Rxdfish/peekboard/images/backligh_schematic.png

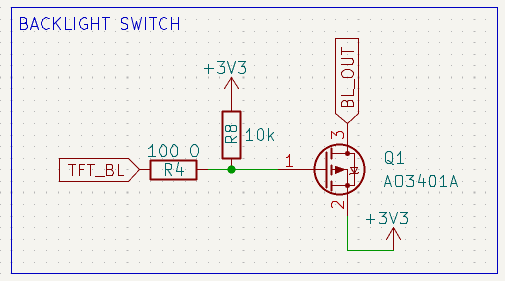
images/backligh_schematic.png
