Rxdfish/peekboard/images/controls_schematic.png

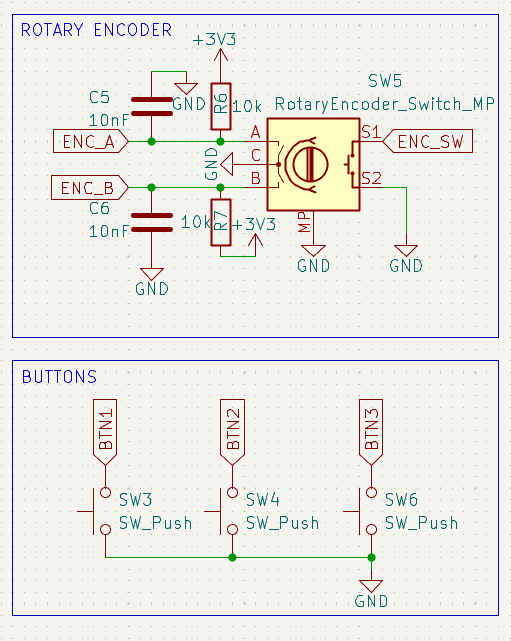
images/controls_schematic.png
