Rxdfish/peekboard/images/ESD_schematic.png

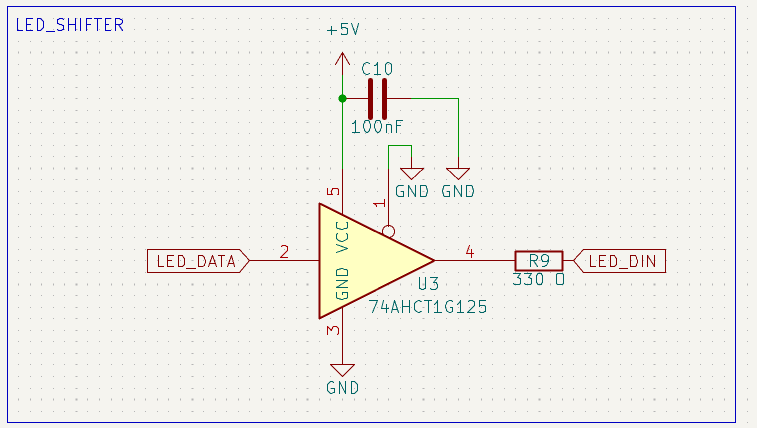
images/ESD_schematic.png
