Rxdfish/peekboard/images/Esp_schematic.png

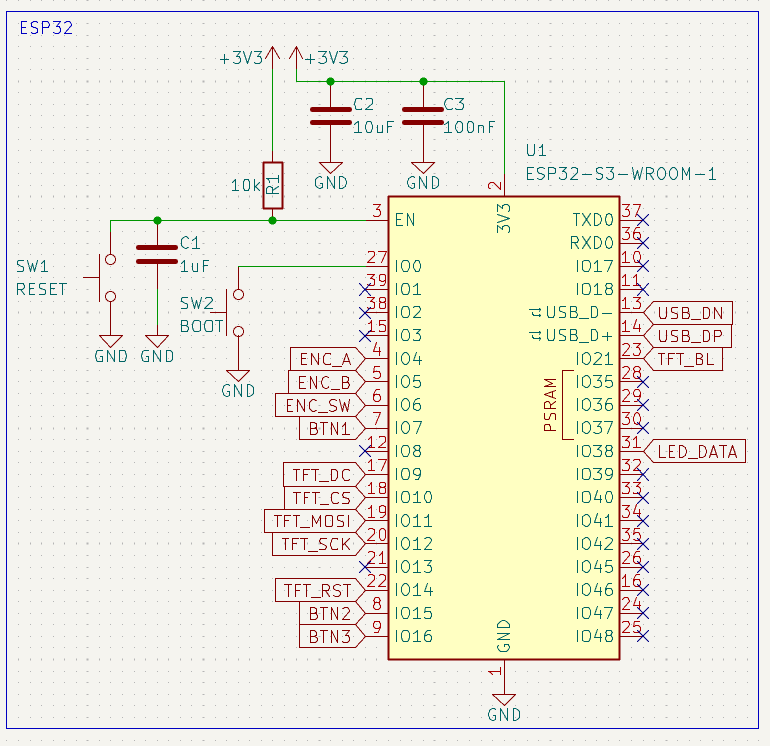
images/Esp_schematic.png
