Rxdfish/peekboard/images/LDO_schematic.png

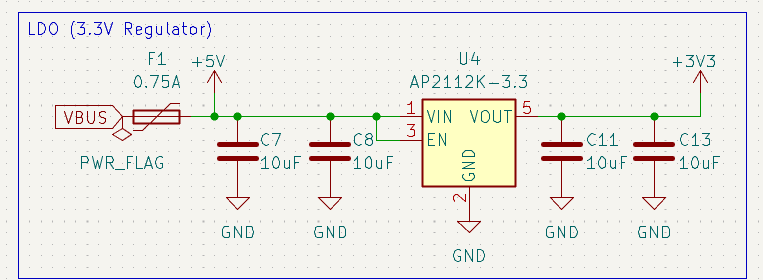
images/LDO_schematic.png
