Rxdfish/peekboard/images/LED_schematic.png

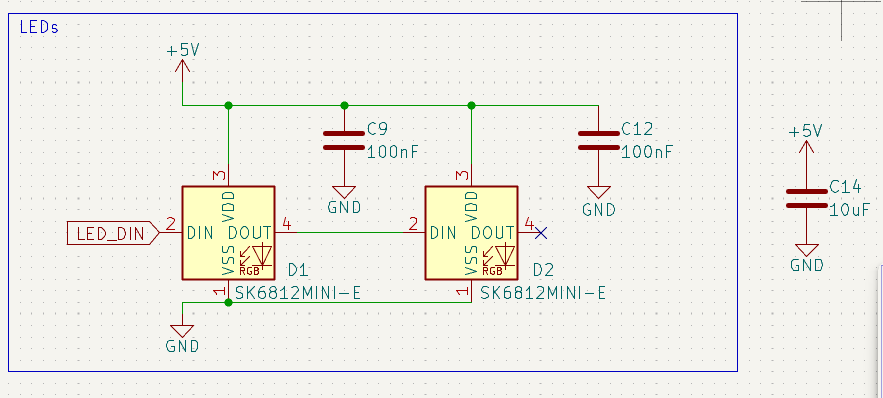
images/LED_schematic.png
