Rxdfish/peekboard/images/screen_schematic.png

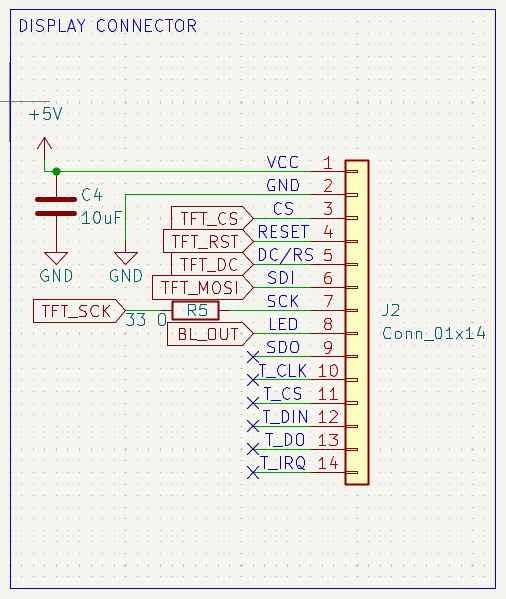
images/screen_schematic.png
