Rxdfish/peekboard/images/USB_schematic.png

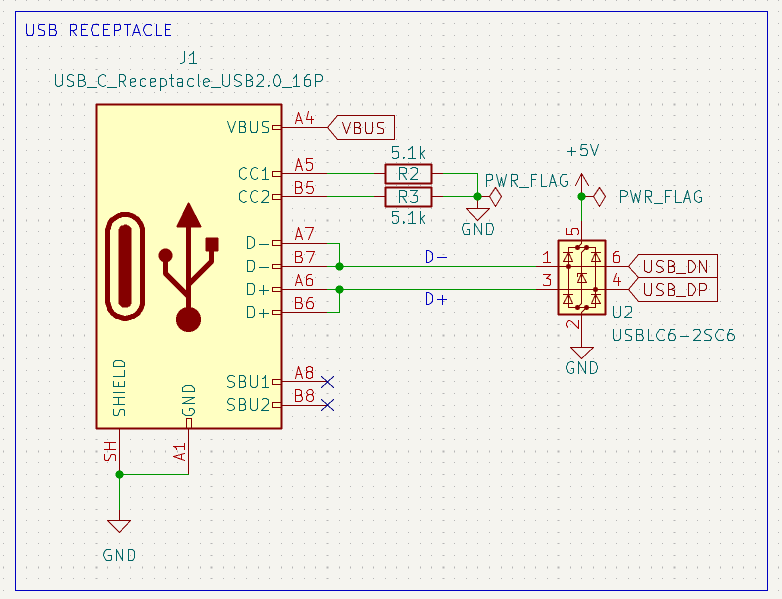
images/USB_schematic.png
