Rxdfish/peekboard/BOM2/Peekboard_Project.csv

Id | Designator | Footprint | Quantity | Designation | Supplier and ref
1 | C1 | C_0805_2012Metric_Pad1.18x1.45mm_HandSolder | 1 | 1uF
2 | C2, C4, C7, C8, C11, C13, C14 | C_0805_2012Metric_Pad1.18x1.45mm_HandSolder | 7 | 10uF
3 | C3, C9, C10, C12 | C_0805_2012Metric_Pad1.18x1.45mm_HandSolder | 4 | 100nF
4 | C5, C6 | C_0805_2012Metric_Pad1.18x1.45mm_HandSolder | 2 | 10nF
5 | D1, D2 | LED_SK6812MINI-E_3.2x2.8mm_P1.5mm_ReverseMount | 2 | SK6812MINI-E
6 | F1 | Fuse_1206_3216Metric_Pad1.42x1.75mm_HandSolder | 1 | 0.75A
7 | J1 | USB_C_Receptacle_HRO_TYPE-C-31-M-12 | 1 | USB_C_Receptacle_USB2.0_16P
8 | J2 | MSP4030_Module | 1 | Conn_01x14
9 | Q1 | SOT-23 | 1 | AO3401A
10 | R1, R6, R7, R8 | R_0805_2012Metric_Pad1.20x1.40mm_HandSolder | 4 | 10k
11 | R2, R3 | R_0805_2012Metric_Pad1.20x1.40mm_HandSolder | 2 | 5.1k
12 | R4 | R_0805_2012Metric_Pad1.20x1.40mm_HandSolder | 1 | 100 O
13 | R5 | R_0805_2012Metric_Pad1.20x1.40mm_HandSolder | 1 | 33 O
14 | R9 | R_0805_2012Metric_Pad1.20x1.40mm_HandSolder | 1 | 330 O
15 | SW1 | SW_PUSH_6mm | 1 | RESET
16 | SW2 | SW_PUSH_6mm | 1 | BOOT
17 | SW3, SW4, SW6 | SW_PUSH_6mm | 3 | SW_Push
18 | SW5 | RotaryEncoder_Alps_EC11E-Switch_Vertical_H20mm | 1 | RotaryEncoder_Switch_MP
19 | U1 | ESP32-S3-WROOM-1 | 1 | ESP32-S3-WROOM-1
20 | U2 | SOT-23-6_Handsoldering | 1 | USBLC6-2SC6
21 | U3 | SOT-23-5_HandSoldering | 1 | 74AHCT1G125
22 | U4 | SOT-23-5_HandSoldering | 1 | AP2112K-3.3
