Rxdfish/peekboard/BOM.csv

Item | Qty | Supplier | Cost/item | Total Cost | link
4" st7796 SPI TFT 480x320 | 1 | EQV Official Store | $20.93 | $20.93 | https://de.aliexpress.com/item/1005007609041421.html?mp=1
USBLC6-2SC6 | 1 | Shop Hui Li Long Store | $1.72 | $1.72 | https://de.aliexpress.com/item/1005007348100430.html?mp=1
AP1221K-3.3 TRG1 | 1 | IC chip Store | $2.36 | $2.36 | https://de.aliexpress.com/item/1005005807114594.html?mp=1
AO3401A | 1 | Supermarket of electronic | $2.09 | $2.09 | https://de.aliexpress.com/item/1005006220143887.html?mp=1
Alps EC11E155244G1 | 1 | DQLZV Official Store | $1.27 | $1.27 | https://de.aliexpress.com/item/1005007644083514.html?mp=1
1206 PTC self recovery fuse 0.75A | 1 | IBUW Electronic Store | $1.93 | $1.93 | https://de.aliexpress.com/item/1005005750933997.html
Estimated total shipping | 1 |  |  | $0.00
