Rxdfish/peekboard/PCB/Peekboard_Project.step

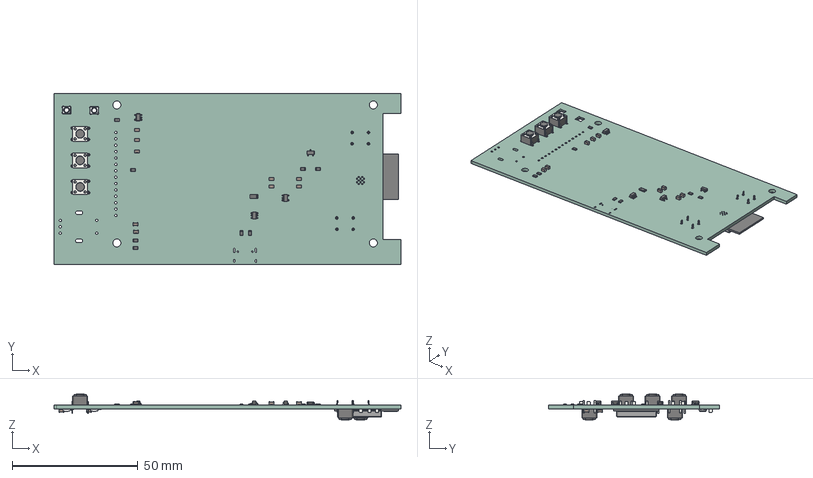
[picture p14: CAD file, 2026-11-03]
PCB/Peekboard_Project.step
138.0 x 68.0 x 10.3 mm
C_0805_2012Metric x 14
SOT-23-5 x 2
Fuse_1206_3216Metric
SOT-23-6
R_0805_2012Metric x 9
SW_PUSH_6mm x 5
SOT-23
Pin1 x 2
Pin2 x 2
Pin3 x 2
Pin4 x 2
ESP32-S3-WROOM-1
Pee4024_PCB
