Rxdfish/peekboard/(list of files, cad)

Other CAD files:
PCB/Peekboard_Project.stl
