Rxdfish/peekboard/PCB/Peekboard_Project.kicad_pcb

## KiCad design PCB/Peekboard_Project.kicad_pcb (2026-11-03)

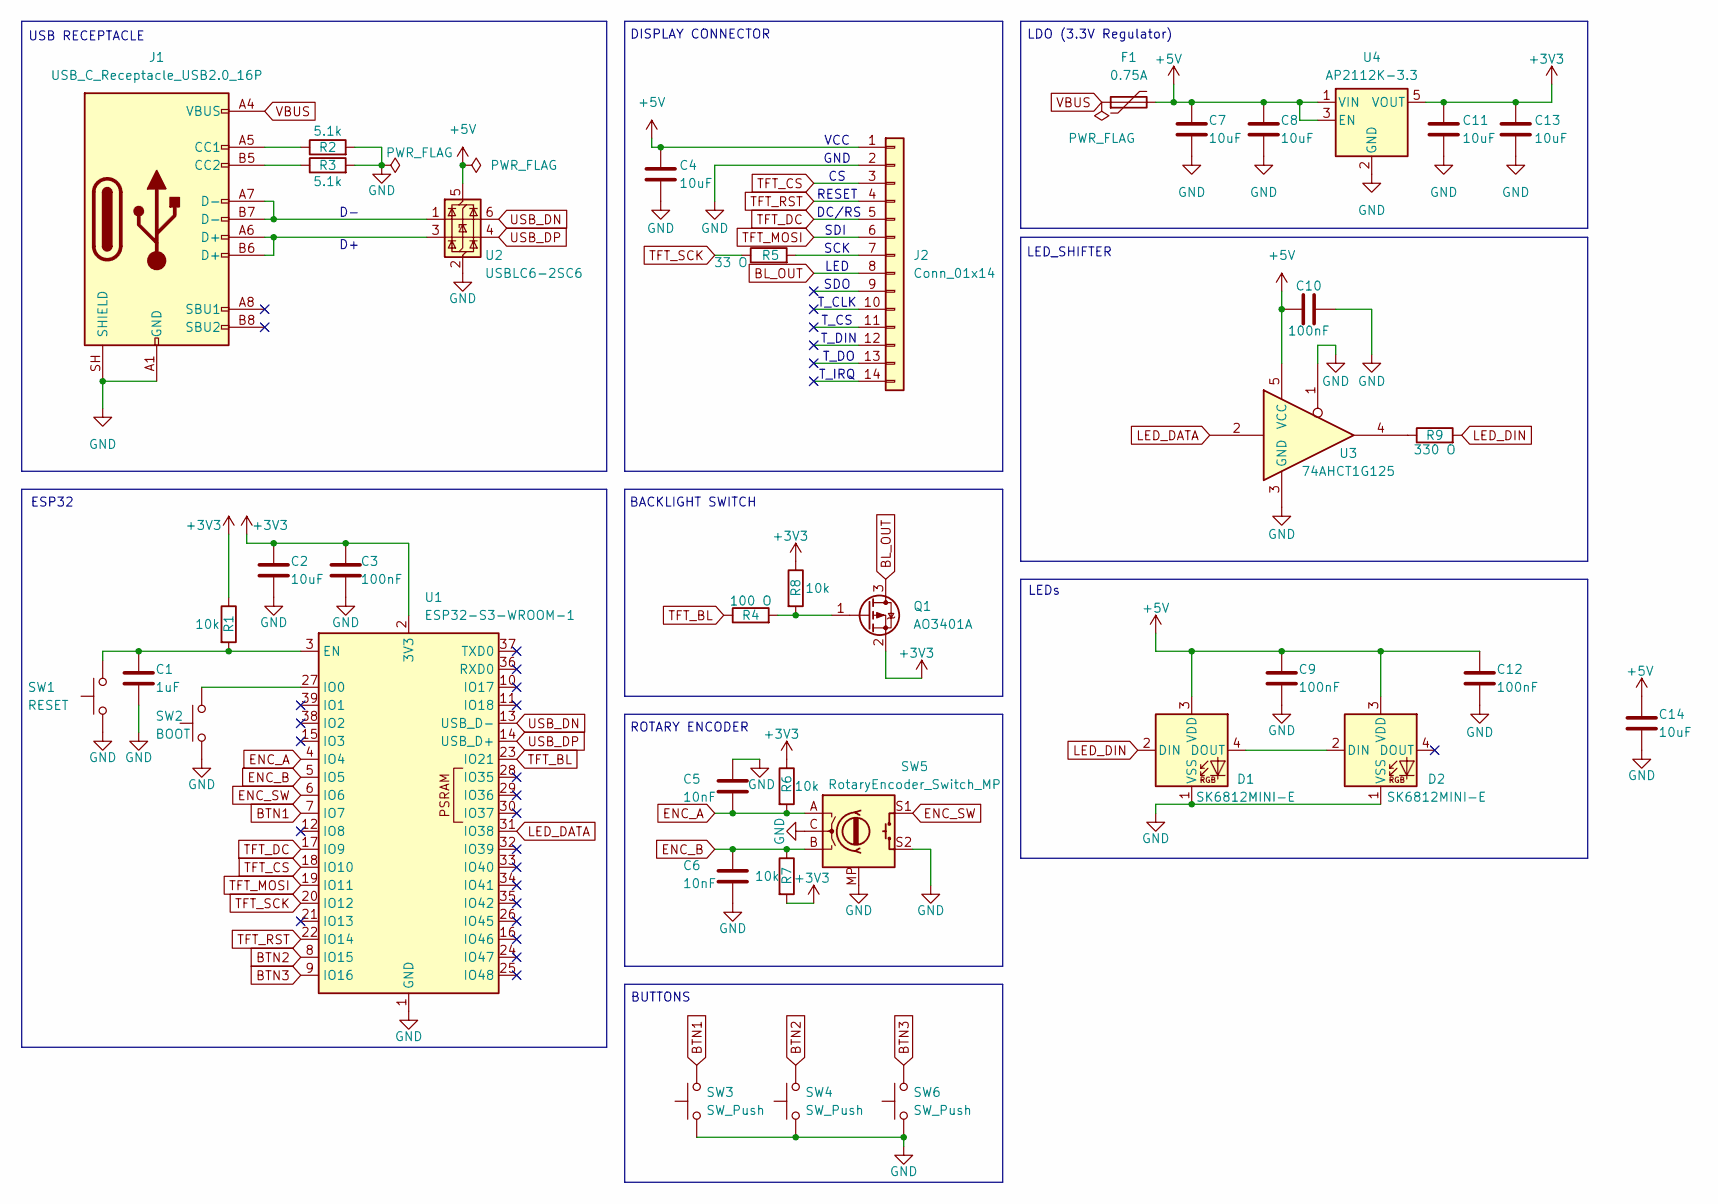
[picture p15: schematic Peekboard_Project.kicad_sch, Peekboard]

Parts:
C1: 1uF; C_0805_2012Metric_Pad1.18x1.45mm_HandSolder
C2, C4, C7, C8, C11, C13, C14: 10uF; C_0805_2012Metric_Pad1.18x1.45mm_HandSolder
C3, C9, C10, C12: 100nF; C_0805_2012Metric_Pad1.18x1.45mm_HandSolder
C5, C6: 10nF; C_0805_2012Metric_Pad1.18x1.45mm_HandSolder
D1, D2: SK6812MINI-E; LED_SK6812MINI-E_3.2x2.8mm_P1.5mm_ReverseMount
F1: 0.75A; Fuse_1206_3216Metric_Pad1.42x1.75mm_HandSolder
J1: USB_C_Receptacle_USB2.0_16P; USB_C_Receptacle_HRO_TYPE-C-31-M-12
J2: Conn_01x14; MSP4030_Module
Q1: AO3401A; SOT-23
R1, R6, R7, R8: 10k; R_0805_2012Metric_Pad1.20x1.40mm_HandSolder
R2, R3: 5.1k; R_0805_2012Metric_Pad1.20x1.40mm_HandSolder
R4: 100 O; R_0805_2012Metric_Pad1.20x1.40mm_HandSolder
R5: 33 O; R_0805_2012Metric_Pad1.20x1.40mm_HandSolder
R9: 330 O; R_0805_2012Metric_Pad1.20x1.40mm_HandSolder
SW1: RESET; SW_PUSH_6mm
SW2: BOOT; SW_PUSH_6mm
SW3, SW4, SW6: SW_Push; SW_PUSH_6mm
SW5: RotaryEncoder_Switch_MP; RotaryEncoder_Alps_EC11E-Switch_Vertical_H20mm
U1: ESP32-S3-WROOM-1
U2: USBLC6-2SC6; SOT-23-6_Handsoldering
U3: 74AHCT1G125; SOT-23-5_HandSoldering
U4: AP2112K-3.3; SOT-23-5_HandSoldering

Connections:
+3V3: C2.1, C3.1, C11.1, C13.1, Q1.2 (S), R1.1, R6.1, R7.2, R8.1, U1.2 (3V3), U4.5 (VOUT)
+5V: C4.1, C7.1, C8.1, C9.1, C10.1, C12.1, C14.1, D1.3 (VDD), D2.3 (VDD), F1.2, J2.1, U2.5 (VBUS), U3.5 (VCC), U4.1 (VIN), U4.3 (EN)
BL_OUT: J2.8, Q1.3 (D)
BTN1: SW3.2, U1.7 (IO7)
BTN2: SW4.2, U1.8 (IO15)
BTN3: SW6.2, U1.9 (IO16)
ENC_A: C5.2, R6.2, SW5.A, U1.4 (IO4)
ENC_B: C6.1, R7.1, SW5.B, U1.5 (IO5)
ENC_SW: SW5.S1, U1.6 (IO6)
GND: C1.2, C2.2, C3.2, C4.2, C5.1, C6.2, C7.2, C8.2, C9.2, C10.2, C11.2, C12.2, C13.2, C14.2, D1.1 (VSS), D2.1 (VSS), J1.A1 (GND), J1.A12 (GND), J1.B1 (GND), J1.B12 (GND), J1.SH (SHIELD), J2.2, R2.2, R3.2, SW1.1, SW2.1, SW3.1, SW4.1, SW5.C, SW5.MP, SW5.S2, SW6.1, U1.1 (GND), U1.40 (GND), U1.41 (GND), U2.2 (GND), U3.1, U3.3 (GND), U4.2 (GND)
LED_DATA: U1.31 (IO38), U3.2
LED_DIN: D1.2 (DIN), R9.2
unnamed: D1.4 (DOUT), D2.2 (DIN)
unnamed: J1.A5 (CC1), R2.1
unnamed: J1.B5 (CC2), R3.1
unnamed: J1.A6 (D+), J1.B6 (D+), U2.3 (I/O2)
unnamed: J1.A7 (D-), J1.B7 (D-), U2.1 (I/O1)
unnamed: J2.7, R5.2
unnamed: Q1.1 (G), R4.2, R8.2
unnamed: R9.1, U3.4
unnamed: C1.1, R1.2, SW1.2, U1.3 (EN)
unnamed: SW2.2, U1.27 (IO0)
TFT_BL: R4.1, U1.23 (IO21)
TFT_CS: J2.3, U1.18 (IO10)
TFT_DC: J2.5, U1.17 (IO9)
TFT_MOSI: J2.6, U1.19 (IO11)
TFT_RST: J2.4, U1.22 (IO14)
TFT_SCK: R5.1, U1.20 (IO12)
USB_DN: U1.13 (USB_D-), U2.6 (I/O1)
USB_DP: U1.14 (USB_D+), U2.4 (I/O2)
VBUS: F1.1, J1.A4 (VBUS), J1.A9 (VBUS), J1.B4 (VBUS), J1.B9 (VBUS)

Notes on the sheet:
LDO (3.3V Regulator)
SCK
T_DO
SDI
ROTARY ENCODER
VCC
T_CS
USB RECEPTACLE
T_IRQ
LED_SHIFTER
ESP32
LEDs
LED
GND
T_DIN
DC/RS
DISPLAY CONNECTOR
SDO
BUTTONS
BACKLIGHT SWITCH
T_CLK
RESET

Board: 2 copper layers, 39 parts (11 on the bottom side), 31 nets, no tracks yet.
