Rxdfish/peekboard/images/PRINT1.jpeg

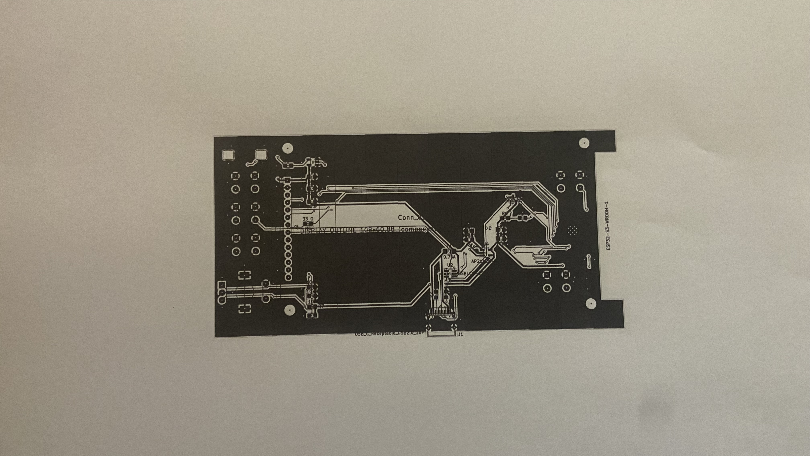
images/PRINT1.jpeg
