Rxdfish/peekboard/images/PRINT2.jpeg

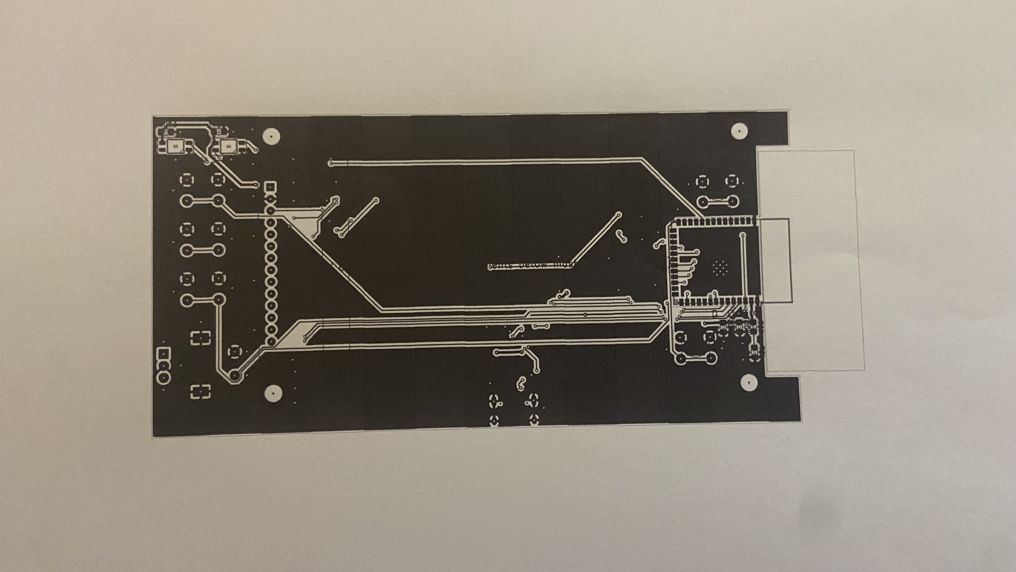
images/PRINT2.jpeg
