Rxdfish/peekboard/images/PRINT3.jpeg

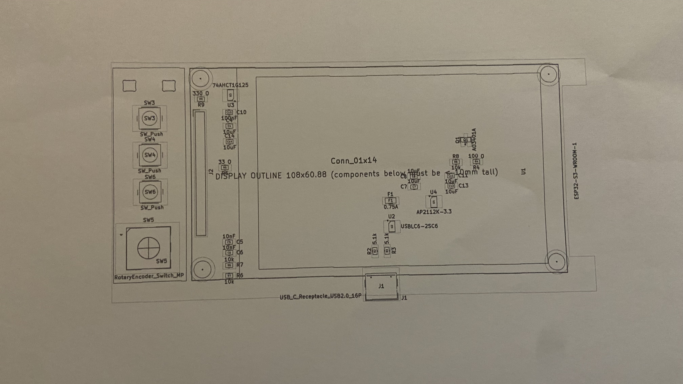
images/PRINT3.jpeg
