Rxdfish/peekboard/images/PRINT4.jpeg

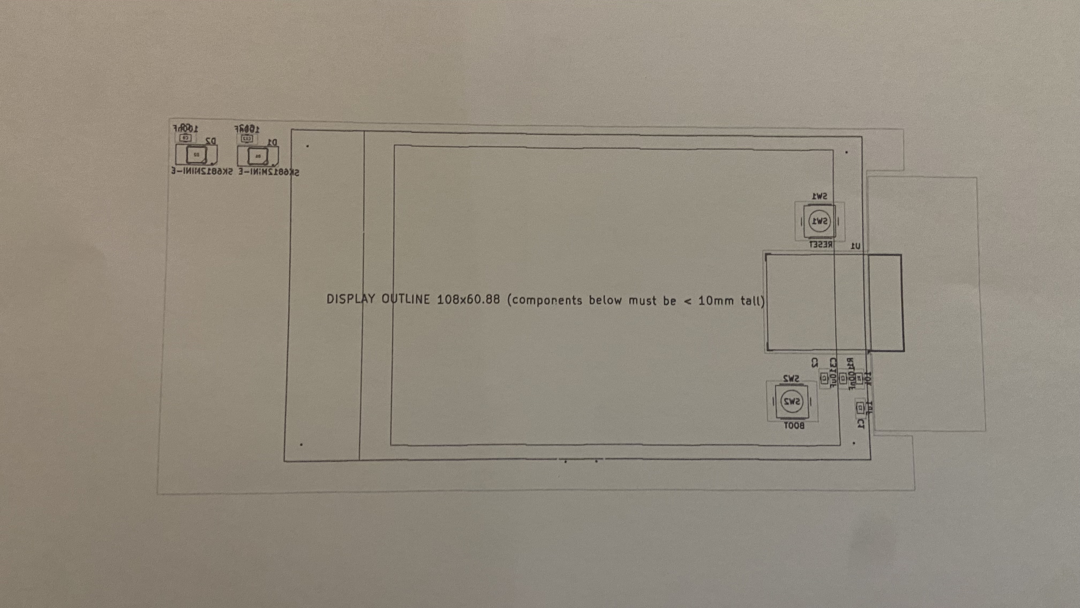
images/PRINT4.jpeg
