Rxdfish/peekboard/JOURNAL.md

# Desk Display: devlog

<!-- Generated by Half Life from project o1kphogve1holy7qx4fpsz0b. Edits here are overwritten on the next sync. -->
<!-- Generated: 2026-11-01T23:01:53.763Z -->

> [!NOTE]
> This devlog is mirrored from [Half Life](https://halflife.hackclub.com) ([open the project](https://halflife.hackclub.com/projects/o1kphogve1holy7qx4fpsz0b)). Editing it here will not change the platform's copy, and the next sync overwrites this file.

> A small desk info monitor that displays some relevant infos about my pc and more.

| Week | Tier | Hours logged | Entries |
| --- | --- | --- | --- |
| Week 4 | Tier 1 | 13.8h | 4 |

## Contents

1. [2026-11-01: INTRO](#2026-11-01-intro)
2. [2026-11-01: INTRO](#2026-11-01-intro)
3. [2026-11-01: Work session](#2026-11-01-work-session)
4. [2026-11-01: INTRO](#2026-11-01-intro)

## Design

### 2026-11-01: INTRO

**4h**

INTRO

Welcome to this journal about my display project "Peekboard". Why the name you ask ? First of all its a peak project XD and on top of that I want to peek at it to see some information.

PROJECT

The idea itself is a display or monitor that I can place below my other monitors and have a dashboard of a variety of infos and cool little things. Its powered by usb c and also gets data over this line.

TABLE OF CONTENTS

- rough idea, dimensions and layout
- rough parts
- first feature ideas

- complete parts list and layout
- complete pin mapout (on paper first)
- complete feature planout

IDEAS LAYOUT AND DIMENSIONS

I started with deciding on an idea and settled with a small dashboard for my setup. I drew the Dimensions how i would like them and coincedentaly the dimensions fit nearly perfect with a 4" TFT SCREEN. Then I added some tactiles and a rotary encoder to the side and cooked up a backstand design for the whole thing.

Here you can see my notes on this as well as some todo scribbles.

ROUGH PARTS

At this stage I only settled with some barebones parts.
The ESP32-S3-WROOM-1-N16R8 as brain because it has decent RAM, which I need for video buffers for the camera feature.

The switches and encoder where also strait forward. I just used what i was familiar with from the earlier projects.

I also did add some SK6812 LEDs because they come in a badge of 20pcs. And I already bought some for another project. So my stock comes in handy now XD.

EARLY FEATURES

At first I only had in mind to display some statistics and use it as a camera monitor. Later came some more features, but I did some research for the cam setup and settled with a relay system over my PC.

PARTS LIST AND LAYOUT

After all primary work was done I resumed with noting all schematic circuits down. This took me two pages of writing which was relatively few compared to my previous project.


The first image shows the receptacle, ESD, LDO and ESP.



The second one showed the TFT connector, LED shifter and LED, Backlight switch, encoders and switches.

FEATURES AND BINDINGS

After that I sat down and created all bindings for the keys and the final features as can be seen in the image.


As always thanks for reading guys and lets go grinding !
Redfish

### 2026-11-01: INTRO

**3.5h**

INTRO

This Journal is all about the BOM. Its research, optimization and checking.

TABLE OF CONTENTS

- Exact parts
- BOM writedown
- Aliexpress parts sourcing
- price optimisation
- Half life BOM import and repo integration

EXACT PARTS

First of all I wrote down the exact parts needed. With detailed names and their quantities.
After that I ended up with a BOM.

BOM

Here is an image of the final BOM with prices, qtd, names and stock



ALIEXPRESS SOURCING

Deciding what parts I would like to get funded was not that easy and in the end I wasnt able to add the ESP32 itself into the funding :( . On the positive side everything else was possible, especially the expensive TFT screen which hit hard into the budget at over 20$.

After that I started searching for the parts on Aliexpress whilst always trying to only use Aliexpress choice parts because of free shipping. Thats a gamechanger ! Even though I found everything it took quite some time to find all that stuff.

Here is my finished cart. (Ignore the other parts, they are from other projects.)





PRICE

The price wasnt perfect at first and im still 0.3$ over the budget right now, but I hope that itll work out.
I pressed the price at some places already and was able to bring it down as much as possible.

HALF LIFE BOM

Last but not least I imported the parts into my HL project and synced it with the repo.


peww! That was some work

Thanks for reading guys !
Redfish (MR holy Yapper)

### 2026-11-01: Work session

**1.68h**

Work session

+

some basic schematic drawings and KICAD preparations, as well as some checks before starting the Timelapse work session.

[Timelapse](https://lookout.hackclub.com/api/media/5683e63e-9e76-4aba-9f72-1230cb08083d/video.mp4)

### 2026-11-01: INTRO

**4.62h**

INTRO

This is the final journal for peekboard for now and im happy to say that im satisfied with the work ive done. Everything turned out really good and im starting to feel like im actually knowing what im doing and that I have learned a new skill. Thanks for this opportunity, without I would never have started to make something!

TABLE OF CONTENTS

- Footprints and pre-checking
- dimension and firmware fetching for the TFT screen
- complete routing of the PCB
- error solving
- real world dimension checking
- filesystem clean up

FOOTPRINTS AND PRE-CHECKS

Before I started to layout and route the PCB I first checked if all parts where there and if there where the necessary footprints for all of them. Then I did some research which footprints I needed to assign and imported some more. After that I assigned every part to a footprint.
-> This partly happened in the timelapse and partly before as prep.

DIMENSIONS FETCH

In order to correctly place the TFT screen, I needed some accurate dimensions and layouts of the IC and board. So I searched and found what I needed together with some firmware and test software.



LAYOUT AND ROUTING

-> This was mostly done on timelapse as well as some more fixing before and after.

ERRORS

There were some errors that needed to be fixed after routing because of some adjustments I made to the nets.

REAL WORLD DIMENSIONS

Out of curriousity I  printed out my PCB layout and checked the size in RL. Turns out its quite small but Im overall really satisfied with the product.









I loved the printouts! They are so intricate and fine.

FILESYSTEM

some boring clean up in my filesystem...

Thanks for reading hackclubbers (if someone is even reading this at all XD)
Redfish_BBBoy!

[Timelapse](https://lookout.hackclub.com/api/media/7c28cc24-205b-4db7-9ab9-bf4cfa4023d9/video.mp4)
