Rxdfish/peekboard/(commit log)

2026-10-31 Sync Desk Display from Half Life
    [BOM.csv]
2026-11-03 All PCB manufacturing files
    [Peekboard_Project.kicad_pcb, Peekboard_Project.kicad_sch]
2026-11-03 stl and step files
    [Peekboard_Project.step, Peekboard_Project.stl]
2026-11-03 full parts boom
    instead of the other funding BOM this is the entire parts BOM exported from KICAD
2026-11-03 complete partslist
    [Peekboard_Project.csv]
2026-11-03 Enhance README with project details and assembly info
    Expanded the README with detailed project information, including assembly instructions, schematic, components, firmware status, and BOM.
2026-11-03 Fix image file name casing for schematic
    Corrected image file name casing in README.
2026-11-03 Fix image path for schematic in README
    Corrected image path in README from 'Images' to 'images'.
